Obi-Wahn/Pico-2W-LoRa-Case/stl/pico_lora_lid.stl

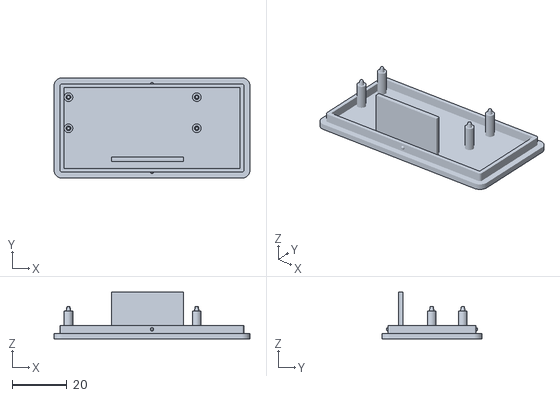
[picture p4: CAD file, 2026-11-13]
stl/pico_lora_lid.stl
71.8 x 36.8 x 17.2
