Obi-Wahn/Pico-2W-LoRa-Case/stl/pico_lora_box.stl

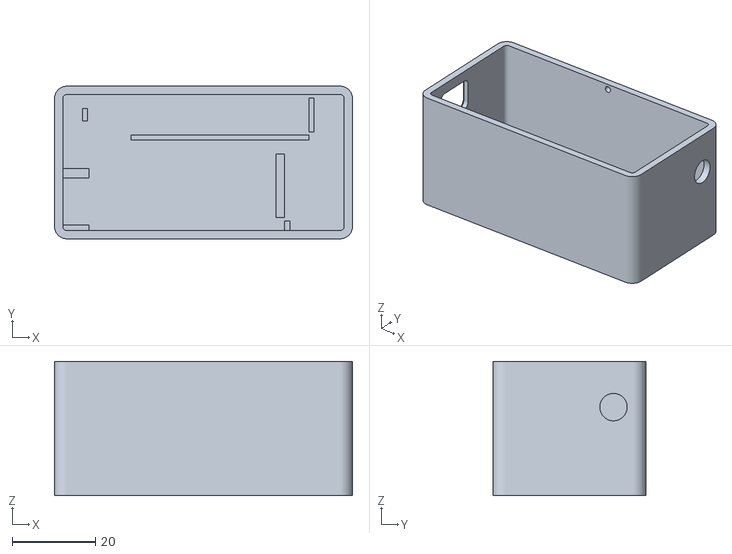
[picture p5: CAD file, 2026-11-13]
stl/pico_lora_box.stl
71.8 x 36.8 x 32.3
