Obi-Wahn/Pico-2W-LoRa-Case/(commit log)

2026-10-31 Gehäuse für Pico 2 W + Waveshare SX1262 LoRa + Akku hinzufügen
    Parametrisches Modell (Python, manifold3d) mit druckfertigen STL-Dateien
    für Unterteil und Deckel, Vorschaubildern und README mit Druck- und
    Montagehinweisen.
    - USB-Öffnung mit ausgedünnter Wand für dicke Stecker
    - Schlitz für den Schiebeschalter unter der LoRa-Platine, LED-Schlitz
    - Akkufach (851451, hochkant) auf der Pin-40-Seite, Kabelweg zwischen den Pins
    - SMA-Buchse seitlich versetzt über dem Akku-Ende
    - Kabelspule im Deckel für das IPEX-SMA-Pigtail
    Claude-Session: https://claude.ai/code/session_01Q2KH3jfCDFBUgC1QqGxHjN
    [pico_lora_box.stl, pico_lora_lid.stl]
2026-10-31 USB-Öffnung nach oben offen, ohne dünnen Steg
    Über der USB-Öffnung blieben nur ca. 1 x 1 mm Wand stehen: bruchgefährdet
    und als Brücke heikel. Die Öffnung ist jetzt als U nach oben offen, den
    oberen Rand bildet der Deckel (Lippe dort ohnehin ausgespart). Abschaltbar
    über USB_OPEN_TOP = False. Deckel unverändert.
    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
    [pico_lora_box.stl]
2026-10-31 USB-Öffnung kleiner, mit durchgehendem Rand oben
    Statt die Öffnung nach oben zu öffnen: Öffnung auf 12 x 7 mm verkleinert
    (nur der Metallteil des Micro-USB-Steckers steckt in der Wand), Fase außen,
    darüber ein durchgehender, voll dicker Rand (USB_RIM = 2,5 mm). Die
    Außentasche entfällt (USB_POCKET = False), die Deckel-Lippe ist an der
    USB-Seite wieder geschlossen. Gehäuse dadurch 0,3 mm niedriger.
    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
    [pico_lora_box.stl, pico_lora_lid.stl]
2026-10-31 USB-Öffnung für die Stecker-Umspritzung, Rand oben bleibt
    Die Umspritzung des Micro-USB-Steckers beginnt nur ~1,7 mm vor der Buchse
    (am Foto gemessen, 11,7 mm breit) und taucht damit in die Wand ein; die
    12 x 7 mm große Öffnung wäre zu klein gewesen. Öffnung jetzt 13,5 x 10,5 mm
    durch die ganze Wand, Fase außen, darüber ein 2 mm hoher Rand in voller
    Wandstärke. Ohne Außentasche, Deckel-Lippe geschlossen. Gehäuse 1 mm höher
    (ca. 72 x 37 x 34 mm). Prüfung mit dickem Stecker (12,5 x 9,5 mm) auch bei
    1 mm Abstand des Platinen-Stapels zur Wand: keine Überschneidung.
    Claude-Session: https://claude.ai/code/session_01Q2KH3jfCDFBU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
    [pico_lora_box.stl, pico_lora_lid.stl]
2026-11-11 .gitignore: lokale Claude-Code-Einstellungen und Schlüsseldateien ausschließen
    .claude/settings.local.json kann freigegebene Befehle samt darin
    enthaltener Passwörter oder Tokens speichern. Die Datei (und andere
    *.local.*-Dateien in .claude/), CLAUDE.local.md sowie typische
    Schlüssel- und Zugangsdatendateien werden jetzt ignoriert.
    .claude/settings.json bleibt bewusst eincheckbar.
    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
2026-11-13 Schalter-Schlitz nach oben versetzt, Schieber liegt mittig
    Am Probedruck lag der Schieber ganz oben am Schlitz, der Schlitz reichte
    unnötig weit nach unten. Er liegt jetzt mittig um den Schieber
    (Mitte ca. 0,6 mm unter der LoRa-Platine): von 1,8 mm unter bis 0,6 mm
    über der Platinenunterseite, 2,4 mm hoch. Die äußere Fase endet oben
    bündig, der Steg zum LED-Schlitz bleibt 1,3 mm stark. Nur das Unterteil
    ändert sich.
    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
    [pico_lora_box.stl]
2026-11-13 Kabelspule im Deckel entfernt
    Am Probedruck hat sich gezeigt: Das mitgelieferte IPEX-SMA-Pigtail ist zu
    kurz, um es um die Spule zu wickeln, und ein lockerer Bogen über dem Pico
    reicht. CABLE_SPOOL ist jetzt standardmäßig aus (Option bleibt für
    längere Kabel). Akku-Niederhalter wieder über die mittlere Akkuhälfte.
    README: Hinweis, das Kabel nicht über die Pico-Befestigungslöcher zu
    legen; Vorschaubild ohne Spule neu erzeugt.
    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
    [pico_lora_lid.stl]
2026-11-13 Ein Fenster für LEDs und Schalter, kleinere USB-Öffnung
    - LED-Schlitz und Schalter-Schlitz zu einem gemeinsamen Fenster
    zusammengelegt (6,8 x 5,9 mm, 1-mm-Fase außen), FRONT_WINDOW
    - USB-Öffnung von 13,5 x 10,5 auf 11,5 x 8,6 mm verkleinert: Umspritzung
    des offiziellen Raspberry-Pi-Micro-USB-Kabels an Fotos gemessen
    (ca. 9,7 x 6,8 mm), 0,9 mm Luft je Seite (USB_PLUG_W/H, USB_CLEAR).
    Rand darüber jetzt 2,9 mm, Gehäusehöhe praktisch unverändert.
    - README und Vorschaubilder angepasst
    Prüfung: keine Überschneidung mit den Platzhalter-Bauteilen; Stecker
    0,4 mm größer als gemessen und Platinen 0,45 mm versetzt passt ebenfalls.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
    [pico_lora_box.stl, pico_lora_lid.stl]
